tn0503/picot_files/(list of files, cad)

Other CAD files:
picot_files/picotV1-1 v12.f3d
