tn0503/picot_files/picot_files/picot1/picot.kicad_pcb

## KiCad design picot_files/picot1/picot.kicad_pcb (2022-08-29)

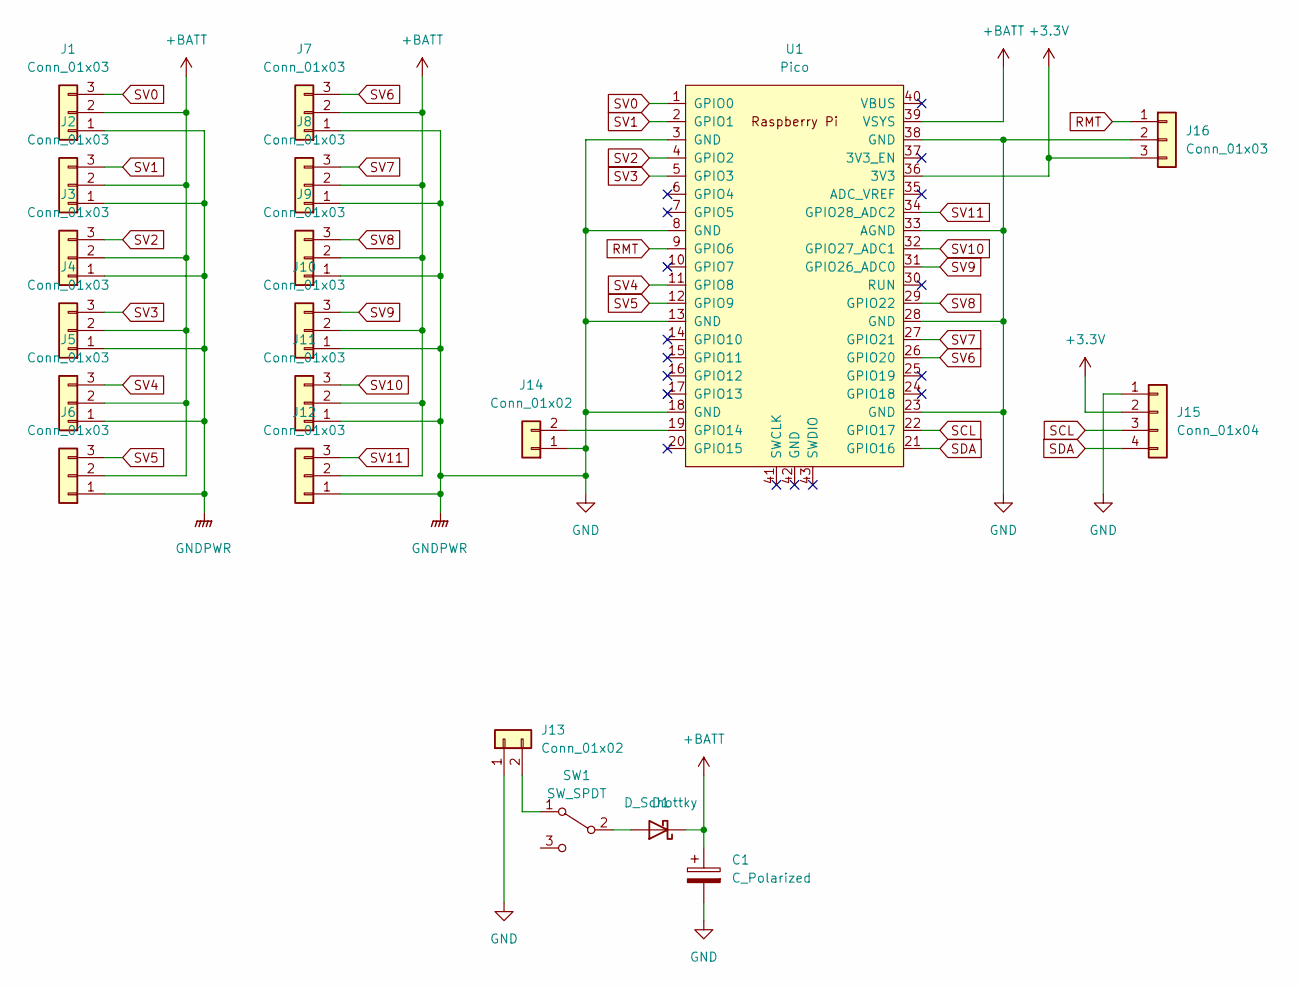
[picture p1: schematic picot.kicad_sch]

Parts:
C1: C_Polarized; CP_Radial_D5.0mm_P2.50mm
D1: D_Schottky; D_A-405_P7.62mm_Horizontal
J1, J2, J3, J4, J5, J6, J7, J8, J9, J10, J11, J12, J16: Conn_01x03; PinHeader_1x03_P2.54mm_Vertical
J13: Conn_01x02; PinHeader_1x02_P2.54mm_Vertical
J14: Conn_01x02; Buzzer_TDK_PS1240P02BT_D12.2mm_H6.5mm
J15: Conn_01x04; PinHeader_1x04_P2.54mm_Vertical
SW1: SW_SPDT; PinHeader_1x03_P2.54mm_Vertical
U1: Pico; RPi_Pico_SMD_TH

Connections:
+3.3V: J15.2, J16.3, U1.36 (3V3)
+BATT: C1.1, D1.1 (K), J1.2, J2.2, J3.2, J4.2, J5.2, J6.2, J7.2, J8.2, J9.2, J10.2, J11.2, J12.2, U1.39 (VSYS)
GNDPWR: C1.2, J1.1, J2.1, J3.1, J4.1, J5.1, J6.1, J7.1, J8.1, J9.1, J10.1, J11.1, J12.1, J13.1, J14.1, J15.1, J16.2, U1.3 (GND), U1.8 (GND), U1.13 (GND), U1.18 (GND), U1.23 (GND), U1.28 (GND), U1.33 (AGND), U1.38 (GND)
unnamed: D1.2 (A), SW1.2 (B)
unnamed: J13.2, SW1.1 (A)
unnamed: J14.2, U1.19 (GPIO14)
RMT: J16.1, U1.9 (GPIO6)
SCL: J15.3, U1.22 (GPIO17)
SDA: J15.4, U1.21 (GPIO16)
SV0: J1.3, U1.1 (GPIO0)
SV1: J2.3, U1.2 (GPIO1)
SV2: J3.3, U1.4 (GPIO2)
SV3: J4.3, U1.5 (GPIO3)
SV4: J5.3, U1.11 (GPIO8)
SV5: J6.3, U1.12 (GPIO9)
SV6: J7.3, U1.26 (GPIO20)
SV7: J8.3, U1.27 (GPIO21)
SV8: J9.3, U1.29 (GPIO22)
SV9: J10.3, U1.31 (GPIO26_ADC0)
SV10: J11.3, U1.32 (GPIO27_ADC1)
SV11: J12.3, U1.34 (GPIO28_ADC2)

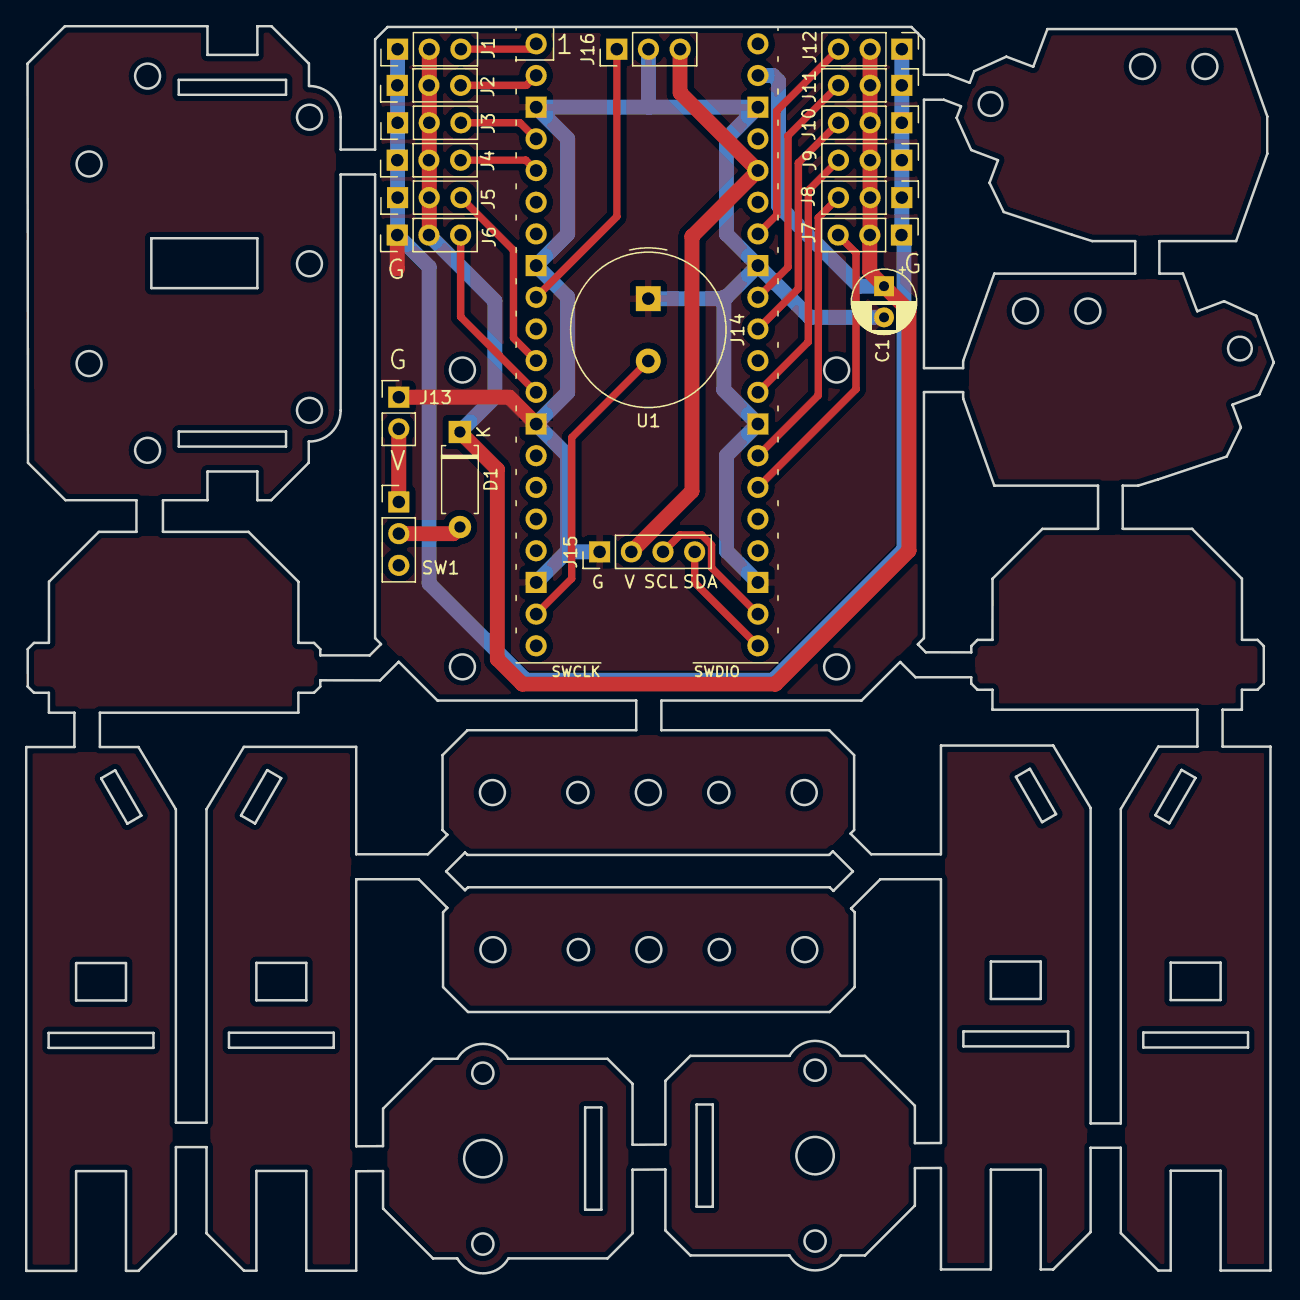
[picture p2: board picot.kicad_pcb from above]

Board: 2 copper layers, 100.0 x 100.0 mm, 20 parts (0 on the bottom side), 21 nets.
