tn0503/picot_files/picot_files/python/async_web_server.py

import network
import socket
import time

from machine import Pin
import uasyncio as asyncio

import robot
import html

pico_led = Pin('LED', machine.Pin.OUT)

ssid = 'YOUR NETWORK'
password = 'YOUR PASSWORD'
ssid = 'WARPSTAR-AC6D64'
password = '435C37A1AD1BE'

wlan = network.WLAN(network.STA_IF)

def connect_to_network():
    wlan.active(True)
    wlan.config(pm = 0xa11140)  # Disable power-save mode
    wlan.connect(ssid, password)

    max_wait = 10
    while max_wait > 0:
        if wlan.status() < 0 or wlan.status() >= 3:
            break
        max_wait -= 1
        print('waiting for connection...')
        time.sleep(1)

    if wlan.status() != 3:
        raise RuntimeError('network connection failed')
    else:
        print('connected')
        status = wlan.ifconfig()
        print('ip = ' + status[0])

async def serve_client(reader, writer):
    print("Client connected")
    request_line = await reader.readline()
    print("Request:", request_line)
    # We are not interested in HTTP request headers, skip them
    while await reader.readline() != b"\r\n":
        pass

    request = str(request_line)
    try:
        request = request.split()[1]
    except IndexError:
        pass
    
    if request == '/lighton?':
        pico_led.on()
    elif request =='/lightoff?':
        pico_led.off()
    elif request == '/stop?':
        robot.set_action('STOP')
    elif request == '/fwrd?':
        robot.set_action('FWRD')
    elif request == '/bwrd?':
        robot.set_action('BWRD')
    elif request == '/ltrn?':
        robot.set_action('LTRN')
    elif request == '/rtrn?':
        robot.set_action('RTRN')
    elif request == '/left?':
        robot.set_action('LEFT')
    elif request == '/rght?':
        robot.set_action('RGHT')
         
    response = html.html
    writer.write('HTTP/1.0 200 OK\r\nContent-type: text/html\r\n\r\n')
    writer.write(response)

    await writer.drain()
    await writer.wait_closed()
    print("Client disconnected")

async def main():
    print('Connecting to Network...')
    connect_to_network()

    print('Setting up webserver...')
    asyncio.create_task(asyncio.start_server(serve_client, "0.0.0.0", 80))
    
    while True:
        robot.drive()
        await asyncio.sleep(0.03)
                
try:
    asyncio.run(main())
finally:
    asyncio.new_event_loop()
