tn0503/picot_files/picot_files/python/connect.py

import network
import socket
import time

ssid = 'YOUR NETWORK'
password = 'YOUR PASSWORD'
ssid = 'WARPSTAR-AC6D64'
password = '435C37A1AD1BE'

def connect():
    #Connect to WLAN
    wlan = network.WLAN(network.STA_IF)
    wlan.active(True)
    wlan.connect(ssid, password)
    while wlan.isconnected() == False:
        print('Waiting for connection...')
        time.sleep(1)
    ip = wlan.ifconfig()[0]
    print(f'Connected on {ip}')
    return ip

def open_socket(ip):
    # Open a socket
    address = (ip, 80)
    connection = socket.socket()
    connection.bind(address)
    connection.listen(1)
    print(connection)

try:
    ip = connect()
    open_socket(ip)
except KeyboardInterrupt:
    machine.reset()
